venomix666/SuperCPM65/README.md

# SuperCPM65
SNES cartrige for CP/M-65, still an untested work in progress
