venomix666/SuperCPM65/SuperCPM65_BOM.ods

Reference | Qty | Value | Footprint | Description | Supplier | Supplier P/N
C1,C2,C3,C5,C6,C7,C9,C10,C11,C12 | 10 | 100n | Capacitor_SMD:C_0805_2012Metric_Pad1.18x1.45mm_HandSolder | Unpolarized capacitor | Mouser | 581-KAM21BR71H104JT
C4,C8 | 2 | 2u2 | Capacitor_SMD:C_0805_2012Metric_Pad1.18x1.45mm_HandSolder | Unpolarized capacitor | Mouser | 581-KAF21KR71E225KU
D1,D2,D3,D4,D8,D9 | 6 | BAT42W-V | Diode_SMD:D_SOD-123 | 30V 0.2A Small Signal Schottky diode, SOD-123 | Mouser | 821-BAT42WRHG
D5,D6,D7 | 3 | LED | LED_SMD:LED_0805_2012Metric | Light emitting diode | Mouser | 604-AP2012SGD3
J1 | 1 | Conn_01x02 | Connector_PinHeader_2.54mm:PinHeader_1x02_P2.54mm_Vertical | Generic connector, single row, 01x02, script generated (kicad-library-utils/schlib/autogen/connector/) | Mouser | 538-22-28-4027
J2 | 1 | Conn_01x06 | Connector_PinHeader_2.54mm:PinHeader_1x06_P2.54mm_Vertical | Generic connector, single row, 01x06, script generated (kicad-library-utils/schlib/autogen/connector/) | Mouser | 538-22-28-4061
J3 | 1 | Conn_01x09 | Connector_PinHeader_2.54mm:PinHeader_1x09_P2.54mm_Vertical | Generic connector, single row, 01x09, script generated (kicad-library-utils/schlib/autogen/connector/) | Mouser | 538-22-28-4091
J4 | 1 | GSD090012SEU | SD_card:AMPHENOL_GSD090012SEU |  | Mouser | 523-GSD090012SEU
J5 | 1 | Mini-DIN-6 | PS2:TE 5749266-1 | 6-pin Mini-DIN connector | Mouser | 571-5749266-1
R1,R2,R3,R7 | 4 | 10k | Resistor_SMD:R_0805_2012Metric_Pad1.20x1.40mm_HandSolder | Resistor | Mouser | 603-RT0805FRE1010KL
R4,R5,R6 | 3 | 1k | Resistor_SMD:R_0805_2012Metric_Pad1.20x1.40mm_HandSolder | Resistor | Mouser | 660-SG73S2ATTD1001F
R8 | 1 | 33k | Resistor_SMD:R_0805_2012Metric_Pad1.20x1.40mm_HandSolder | Resistor | Mouser | 755-KTR10EZPF3302
U1 | 1 | 74HC14 | Package_SO:SOIC-14_3.9x8.7mm_P1.27mm | Hex inverter schmitt trigger | Mouser | 757-74HC14D
U2 | 1 | PIC12F629-IP | Package_DIP:DIP-8_W7.62mm_Socket |  | Mouser | 579-PIC12F629IP
U3 | 1 | SST39SF010 | Package_DIP:DIP-32_W15.24mm_Socket | Silicon Storage Technology (SSF) 128k x 8 Flash ROM | Mouser | 804-39SF010A7CPHE
U4 | 1 | W65C22NxP | Package_DIP:DIP-40_W15.24mm | CMOS Versatile Interface Adapter (VIA), 20-pin I/O, 2 Timer/Counters, NMOS-Compatible, DIP-40 | Mouser | 955-W65C22S6TPG-14
U5,U6 | 2 | 74HC595 | Package_SO:SOIC-16_3.9x9.9mm_P1.27mm | 8-bit serial in/out Shift Register 3-State Outputs | Mouser | 771-74HCT595DQ100118
U7 | 1 | TXB0104D | Package_SO:SOIC-14_3.9x8.7mm_P1.27mm | 4-Bit Bidirectional Voltage-Level Translator, Auto Direction Sensing and ±15-kV ESD Protection, 1.2 - 3.6V APort, 1.65 - 5.5V BPort, SOIC-14 | Mouser | 595-TXB0104D
U8 | 1 | AP2205-33W5-7 | Package_TO_SOT_SMD:SOT-23-5 | 200mA low dropout linear regulator, wide input voltage range, 3.3V fixed positive output, SOT-23-5 | Mouser | 621-AP2205-33W5-7
