venomix666/SuperCPM65/Local_lib/PS2/c-5749266-1-a-3d.stp

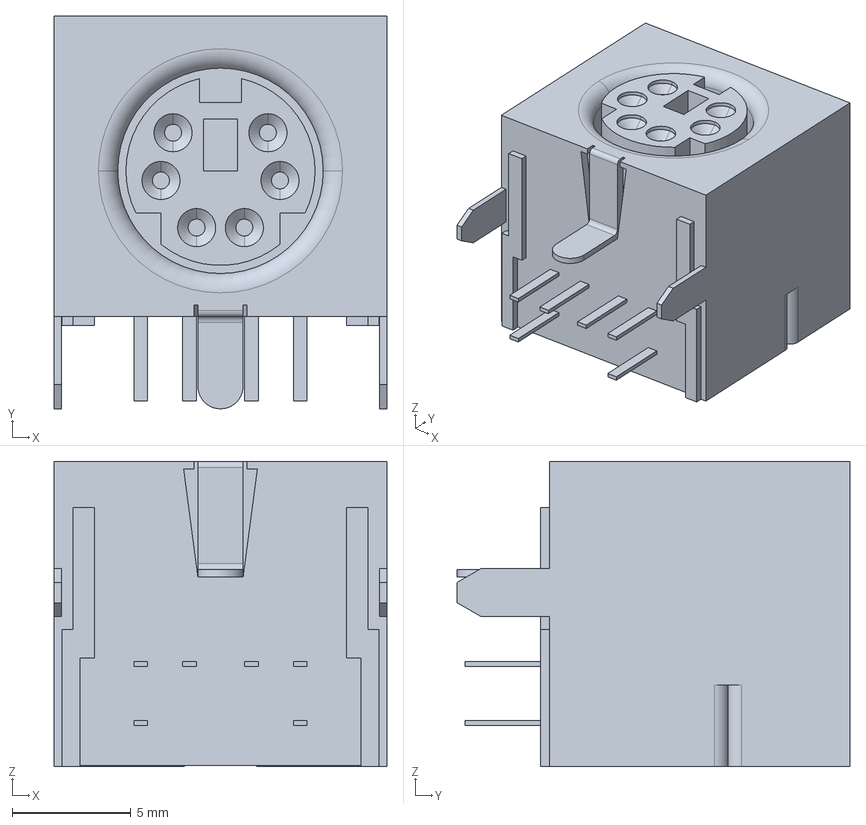
[picture p1: CAD file, 2025-03-16]
Local_lib/PS2/c-5749266-1-a-3d.stp
14.0 x 16.5 x 12.8 mm
