venomix666/SuperCPM65/Local_lib/step_files/DIP-32 W15.24mm IC with Socket.stp

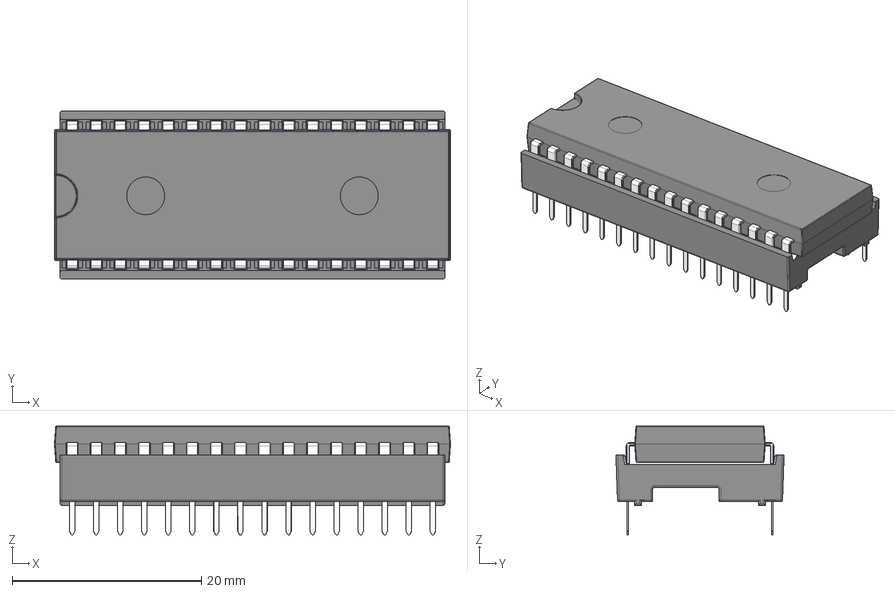
[picture p2: CAD file, 2025-03-16]
Local_lib/step_files/DIP-32 W15.24mm IC with Socket.stp
41.8 x 17.8 x 11.5 mm
Stamped Dual Wipe Contact for DIP Sockets x 32
Body DIP-48 Socket
IC Beinchen x 32
DIP-32 W15.24
