venomix666/SuperCPM65/Local_lib/step_files/DIP-8 W7.62mm IC with Socket.stp

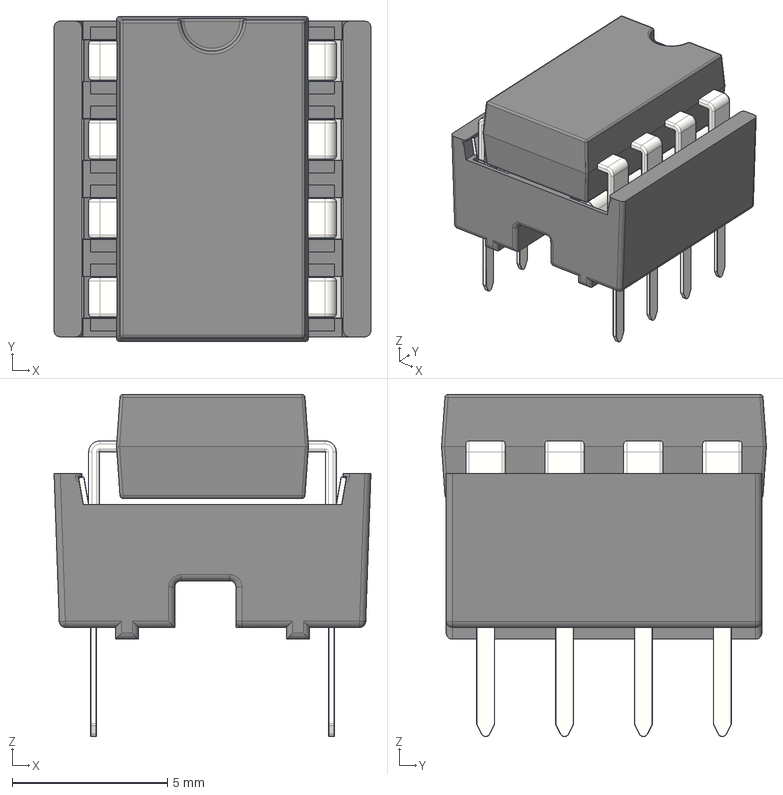
[picture p3: CAD file, 2025-03-16]
Local_lib/step_files/DIP-8 W7.62mm IC with Socket.stp
10.2 x 10.5 x 11.0 mm
Stamped Dual Wipe Contact for DIP Sockets x 8
Body DIP-8 P7.62mm Socket
IC Beinchen x 8
DIP-8 W7.62
