venomix666/SuperCPM65/Local_lib/SD_card/GSD090012SEU.step

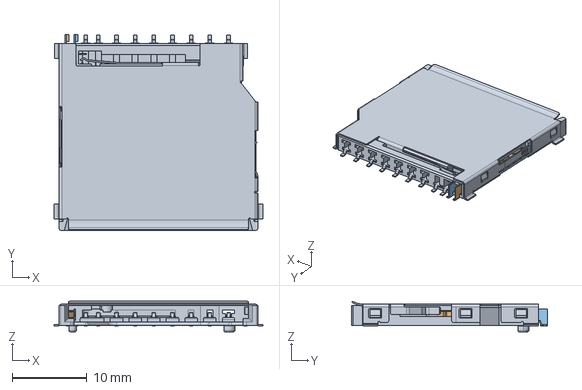
[picture p4: CAD file, 2025-03-16]
Local_lib/SD_card/GSD090012SEU.step
28.0 x 26.2 x 4.13 mm
