venomix666/SuperCPM65/Assembly_Drawing/SuperCPM65__Assembly.pdf

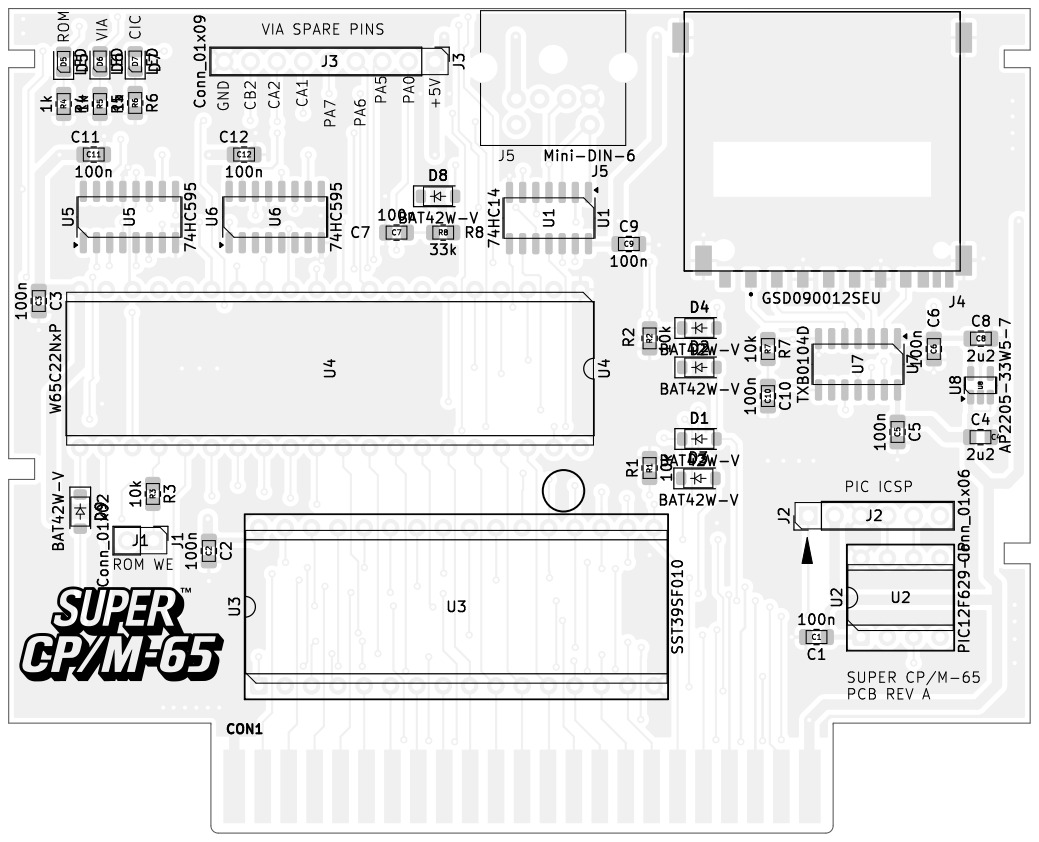
[picture p5: page 1]

CIC CA1 PA0 SUPER CP/M-65 PCB REV A PA6CA2 PA7PA5 +5V ROM WE CB2 PIC ICSP VIAVIA SPARE PINS GND ROM U5 D3 U4U7 J2 J3 C7 R5 C6 C4

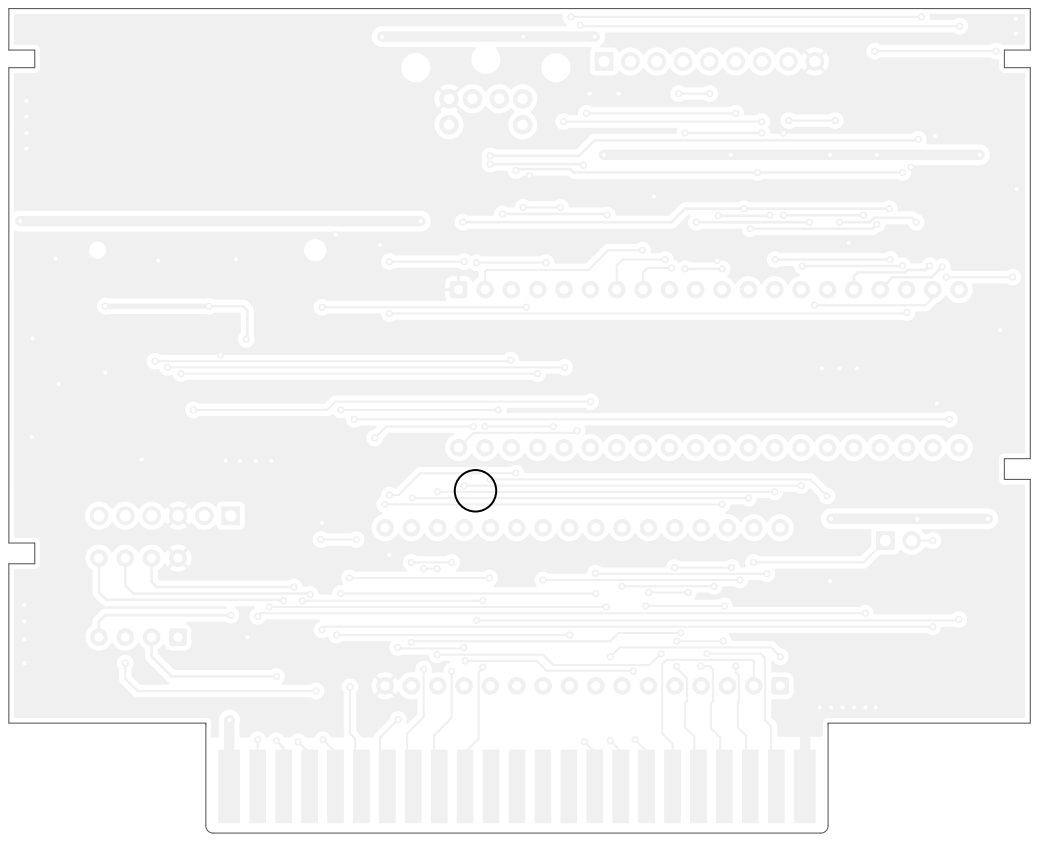
[picture p6: page 2]
D Date: KiCad; E.D.A. 9.0.1 Size: A4; Rev:; Id: /1 Title: File: SuperCPM65.kicad_pcb Sheet: Black; And; White; BOT Board2Pdf:; Black; BOT -; Page 2/2
