venomix666/SuperCPM65/Schematics/SuperCPM65_Schematics_PA5.pdf

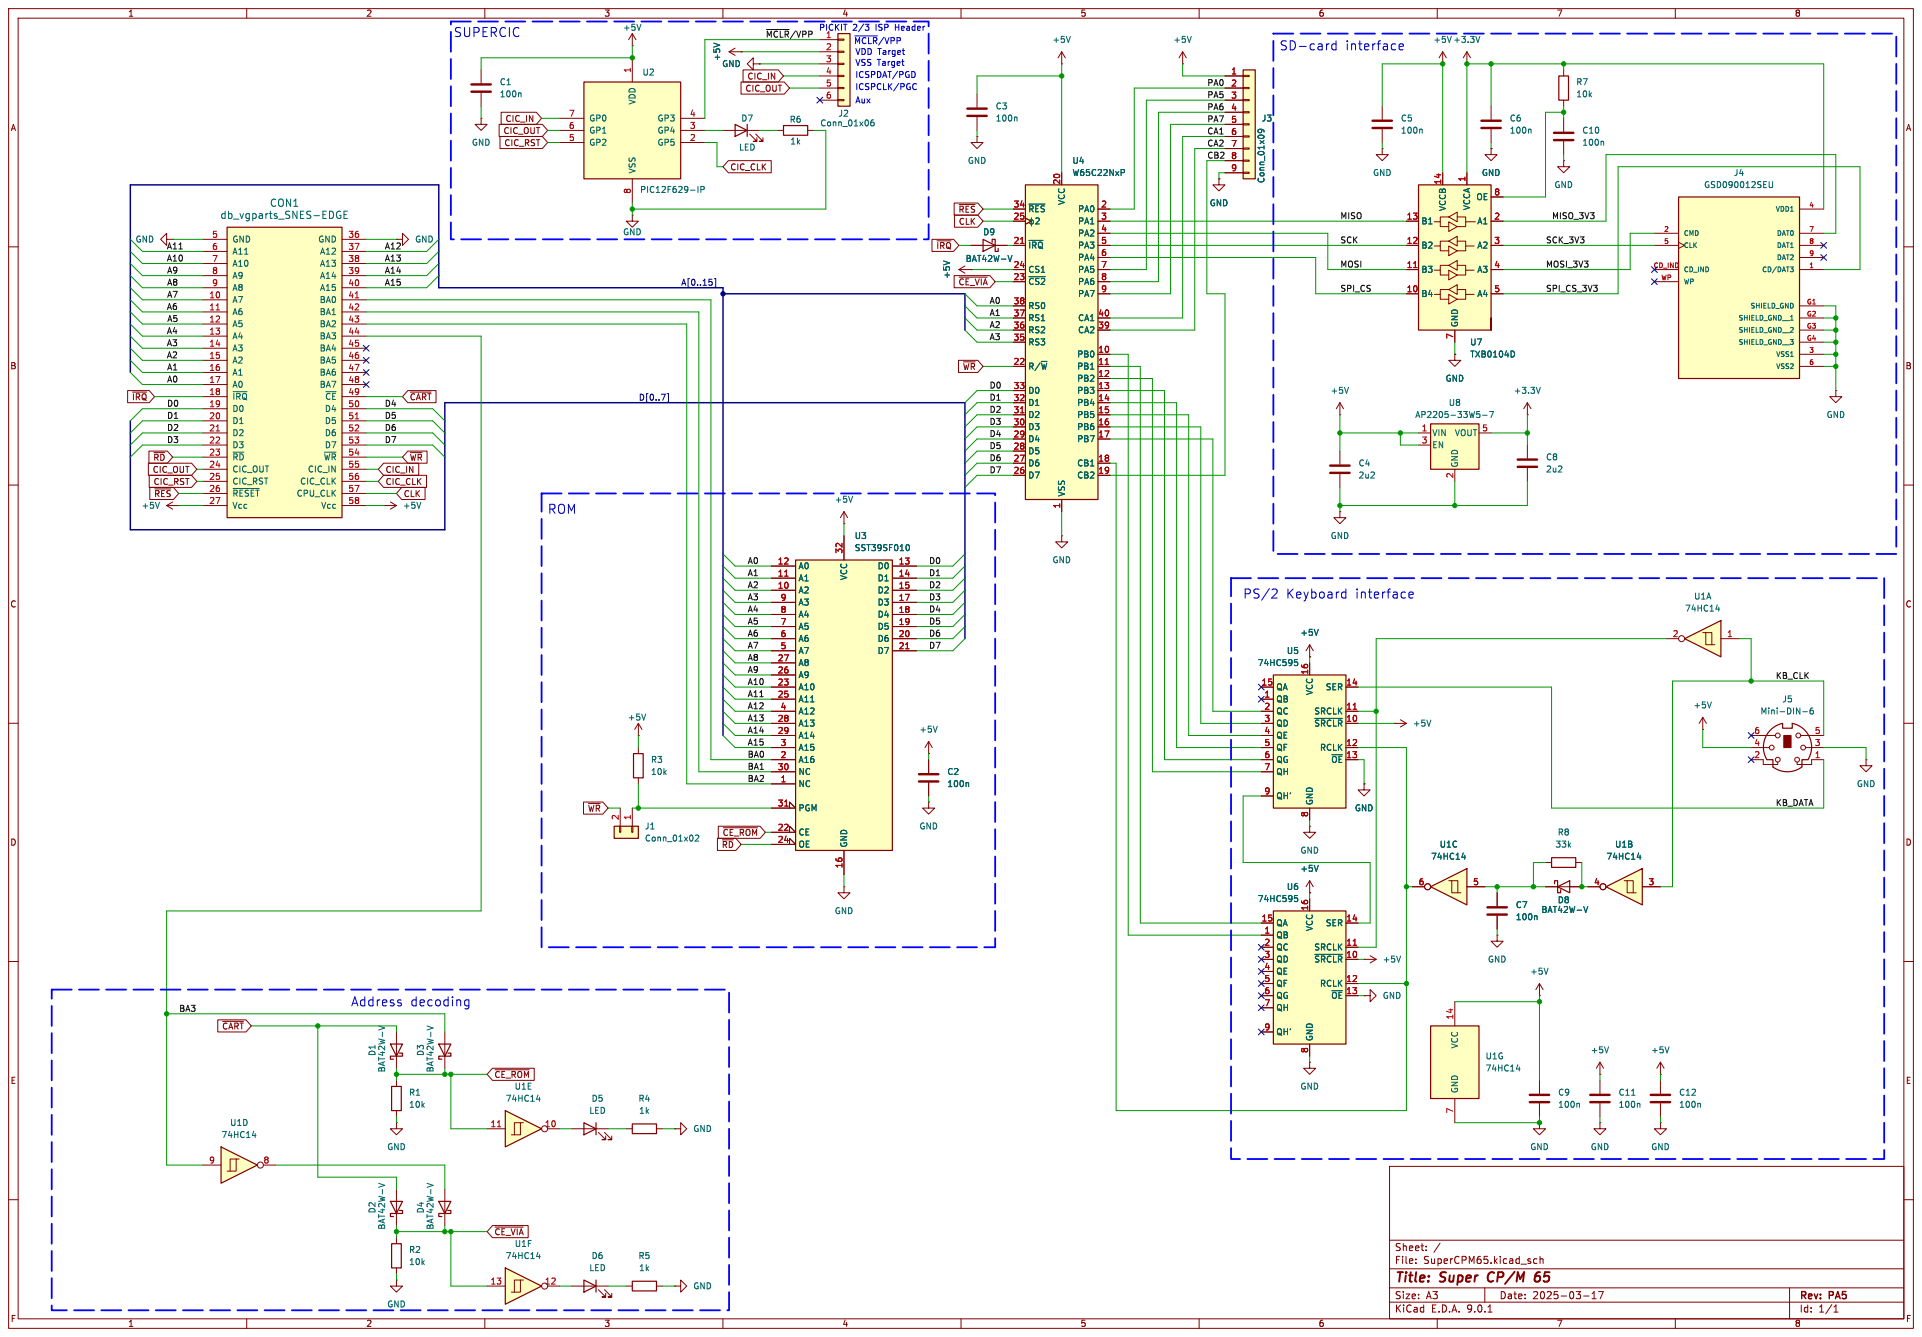
[picture p7: page 1]

VDD Target Aux SUPERCIC

SER 14 SRCLK 11 ~{SRCLR} 10 RCLK 12 ~{OE} 13 VCC 16 GND

GND

Id: 1/1 Title: Super CP/M 65
