venomix666/SuperCPM65/SuperCPM65.kicad_pcb

## KiCad design SuperCPM65.kicad_pcb (2025-04-09)

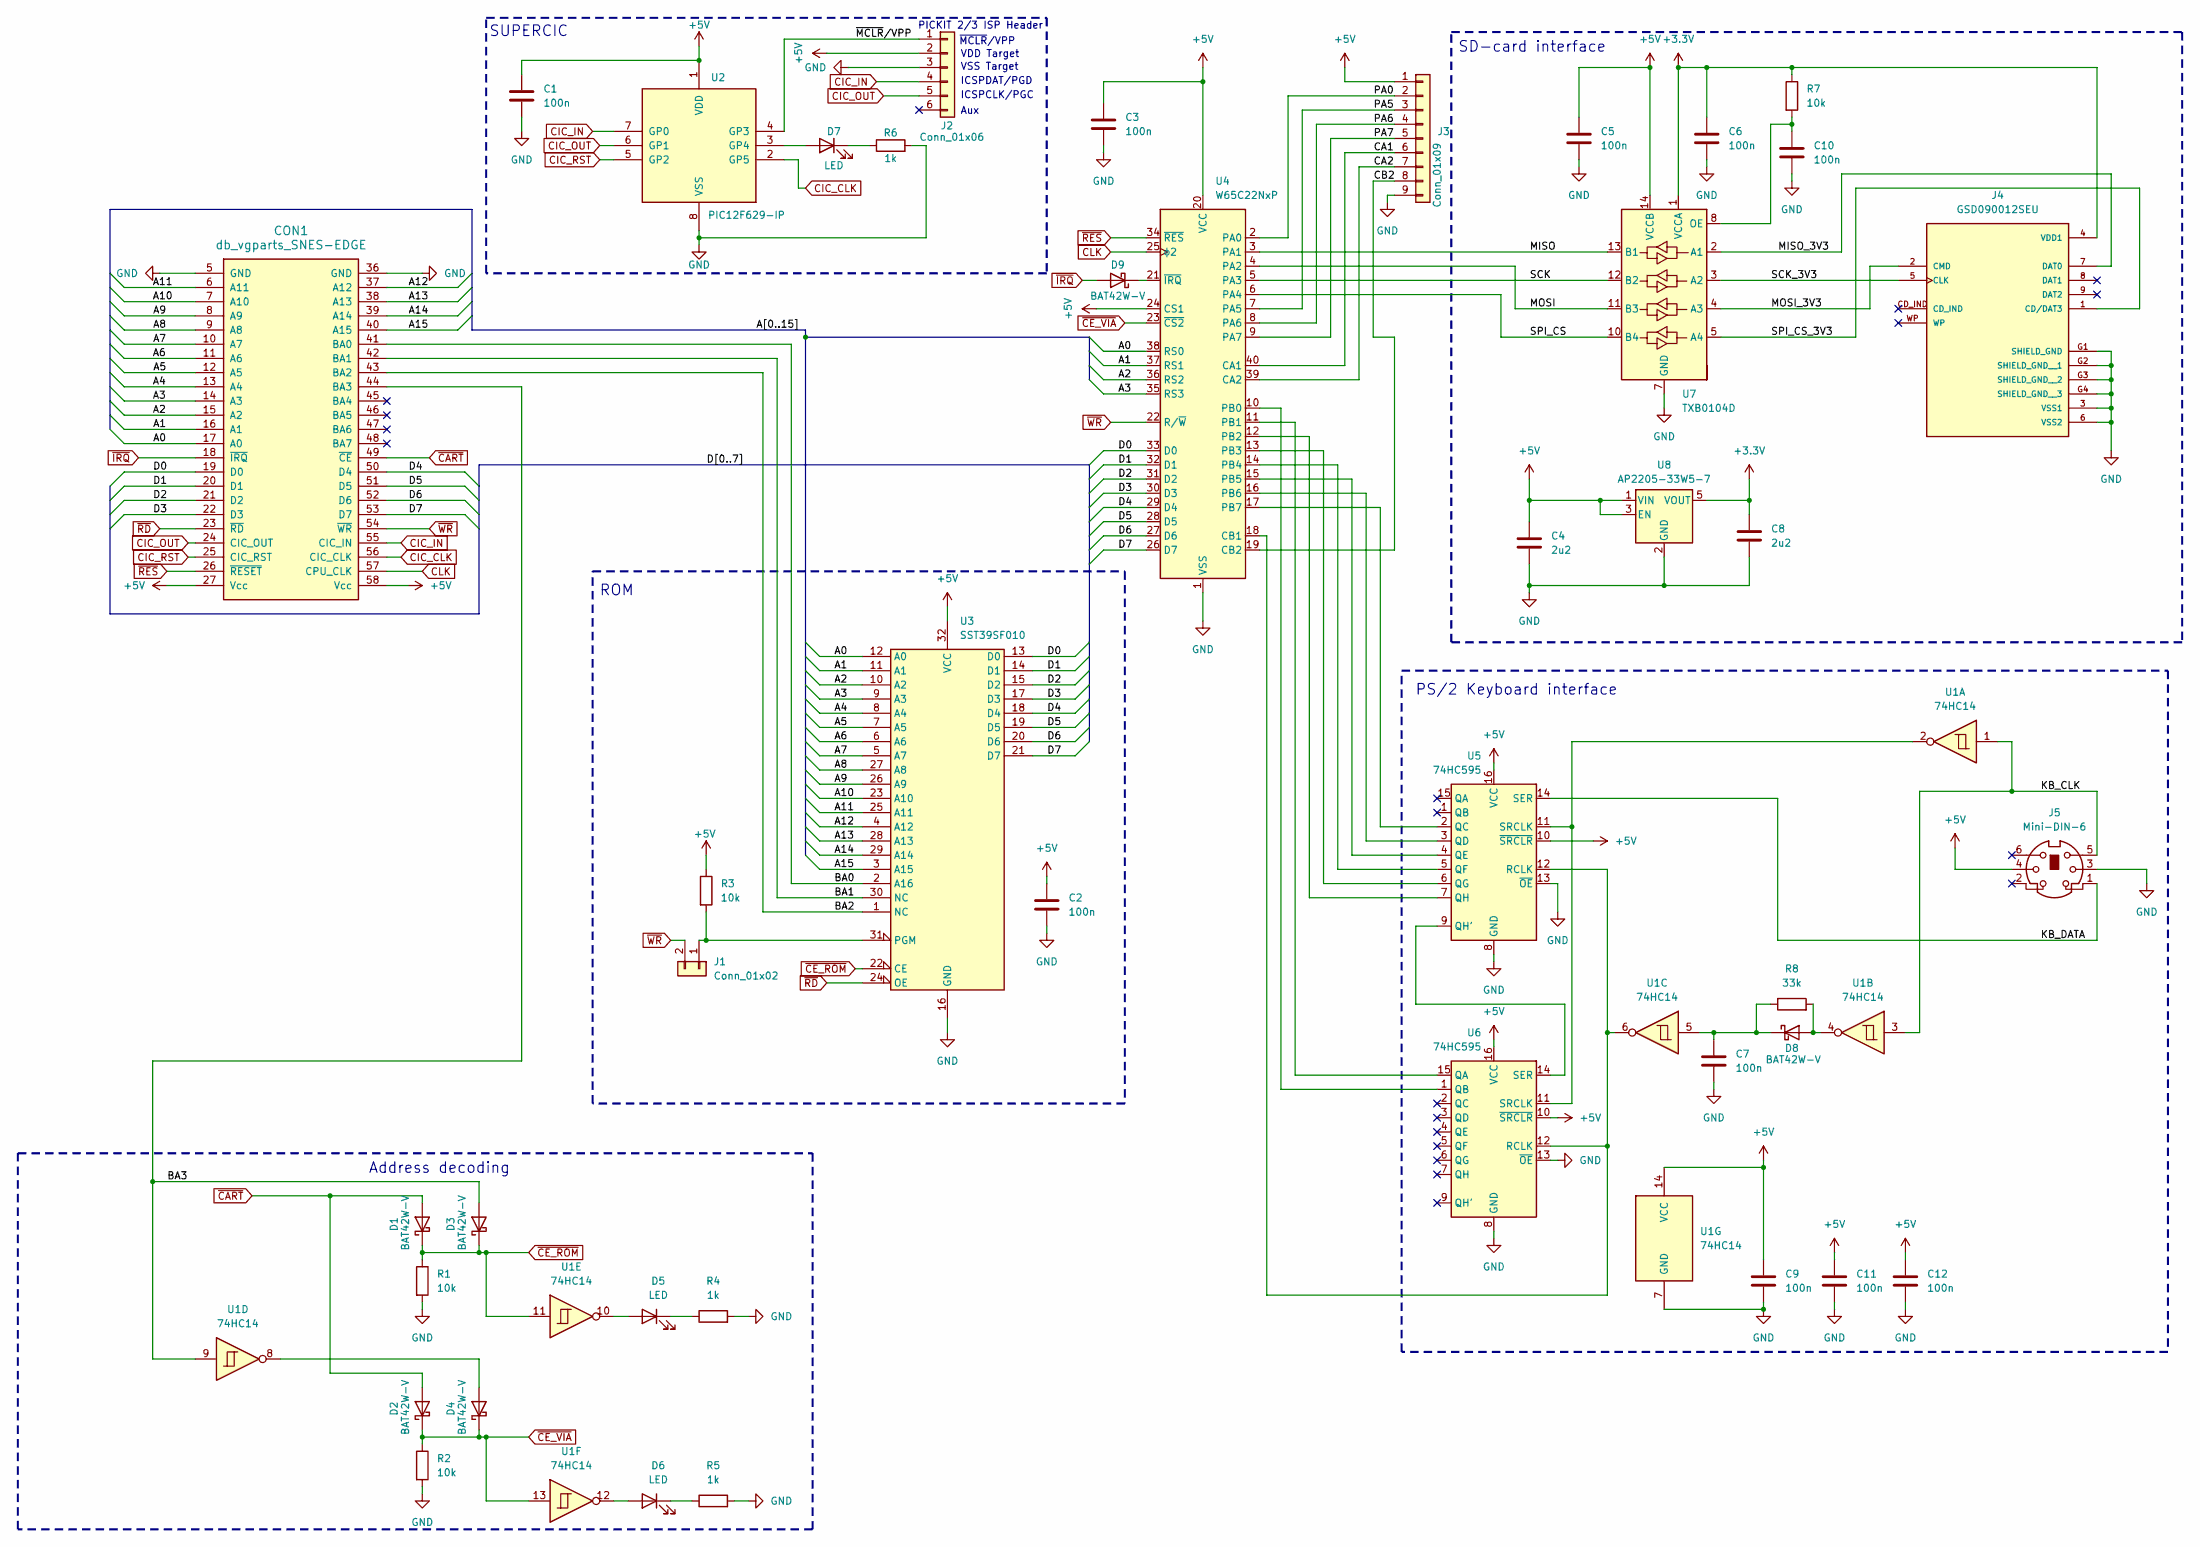
[picture p8: schematic SuperCPM65.kicad_sch, Super CP/M 65]

Parts:
C1, C2, C3, C5, C6, C7, C9, C10, C11, C12: 100n; C_0805_2012Metric_Pad1.18x1.45mm_HandSolder
C4, C8: 2u2; C_0805_2012Metric_Pad1.18x1.45mm_HandSolder
CON1: db_vgparts_SNES-EDGE; SNES-EDGE-Bigger
D1, D2, D3, D4, D8, D9: BAT42W-V; D_SOD-123
D5, D6, D7: LED; LED_0805_2012Metric
J1: Conn_01x02; PinHeader_1x02_P2.54mm_Vertical
J2: Conn_01x06; PinHeader_1x06_P2.54mm_Vertical
J3: Conn_01x09; PinHeader_1x09_P2.54mm_Vertical
J4: GSD090012SEU; AMPHENOL_GSD090012SEU; PARTREV E
J5: Mini-DIN-6; TE 5749266-1
R1, R2, R3, R7: 10k; R_0805_2012Metric_Pad1.20x1.40mm_HandSolder
R4, R5, R6: 1k; R_0805_2012Metric_Pad1.20x1.40mm_HandSolder
R8: 33k; R_0805_2012Metric_Pad1.20x1.40mm_HandSolder
U1: 74HC14; SOIC-14_3.9x8.7mm_P1.27mm
U2: PIC12F629-IP; DIP-8_W7.62mm_Socket
U3: SST39SF010; DIP-32_W15.24mm_Socket
U4: W65C22NxP; DIP-40_W15.24mm
U5, U6: 74HC595; SOIC-16_3.9x9.9mm_P1.27mm
U7: TXB0104D; SOIC-14_3.9x8.7mm_P1.27mm
U8: AP2205-33W5-7; SOT-23-5

Connections:
+3.3V: C6.1, C8.1, J4.4 (VDD1), R7.1, U7.1 (VCCA), U8.5 (VOUT)
+5V: C1.1, C2.1, C3.1, C4.1, C5.1, C9.1, C11.1, C12.1, CON1.27 (Vcc), CON1.58 (Vcc), J2.2, J3.1, J5.4, R3.1, U1.14 (VCC), U2.1 (VDD), U3.32 (VCC), U4.20 (VCC), U4.24 (CS1), U5.10 (~SRCLR), U5.16 (VCC), U6.10 (~SRCLR), U6.16 (VCC), U7.14 (VCCB), U8.1 (VIN), U8.3 (EN)
/A0: CON1.17 (A0), U3.12 (A0), U4.38 (RS0)
/A1: CON1.16 (A1), U3.11 (A1), U4.37 (RS1)
/A2: CON1.15 (A2), U3.10 (A2), U4.36 (RS2)
/A3: CON1.14 (A3), U3.9 (A3), U4.35 (RS3)
/A4: CON1.13 (A4), U3.8 (A4)
/A5: CON1.12 (A5), U3.7 (A5)
/A6: CON1.11 (A6), U3.6 (A6)
/A7: CON1.10 (A7), U3.5 (A7)
/A8: CON1.9 (A8), U3.27 (A8)
/A9: CON1.8 (A9), U3.26 (A9)
/A10: CON1.7 (A10), U3.23 (A10)
/A11: CON1.6 (A11), U3.25 (A11)
/A12: CON1.37 (A12), U3.4 (A12)
/A13: CON1.38 (A13), U3.28 (A13)
/A14: CON1.39 (A14), U3.29 (A14)
/A15: CON1.40 (A15), U3.3 (A15)
/BA0: CON1.41 (BA0), U3.2 (A16)
/BA1: CON1.42 (BA1), U3.30 (NC)
/BA2: CON1.43 (BA2), U3.1 (NC)
/BA3: CON1.44 (BA3), D3.2 (A), U1.9
/CA1: J3.6, U4.40 (CA1)
/CA2: J3.7, U4.39 (CA2)
/CB2: J3.8, U4.19 (CB2)
/D0: CON1.19 (D0), U3.13 (D0), U4.33 (D0)
/D1: CON1.20 (D1), U3.14 (D1), U4.32 (D1)
/D2: CON1.21 (D2), U3.15 (D2), U4.31 (D2)
/D3: CON1.22 (D3), U3.17 (D3), U4.30 (D3)
/D4: CON1.50 (D4), U3.18 (D4), U4.29 (D4)
/D5: CON1.51 (D5), U3.19 (D5), U4.28 (D5)
/D6: CON1.52 (D6), U3.20 (D6), U4.27 (D6)
/D7: CON1.53 (D7), U3.21 (D7), U4.26 (D7)
/KB_CLK: J5.5, U1.1, U1.3
/KB_DATA: J5.1, U5.14 (SER)
/MISO: U4.3 (PA1), U7.13 (B1)
/MISO_3V3: J4.7 (DAT0), U7.2 (A1)
/MOSI: U4.4 (PA2), U7.11 (B3)
/MOSI_3V3: J4.2 (CMD), U7.4 (A3)
/PA0: J3.2, U4.2 (PA0)
/PA5: J3.3, U4.7 (PA5)
/PA6: J3.4, U4.8 (PA6)
/PA7: J3.5, U4.9 (PA7)
/SCK: U4.5 (PA3), U7.12 (B2)
/SCK_3V3: J4.5 (CLK), U7.3 (A2)
/SPI_CS: U4.6 (PA4), U7.10 (B4)
/SPI_CS_3V3: J4.1 (CD/DAT3), U7.5 (A4)
/~MCLR/VPP: J2.1, U2.4 (GP3)
CIC_CLK: CON1.56 (CIC_CLK), U2.2 (GP5)
CIC_IN: CON1.55 (CIC_IN), J2.4, U2.7 (GP0)
CIC_OUT: CON1.24 (CIC_OUT), J2.5, U2.6 (GP1)
CIC_RST: CON1.25 (CIC_RST), U2.5 (GP2)
CLK: CON1.57 (CPU_CLK), U4.25 (ϕ2)
GND: C1.2, C2.2, C3.2, C4.2, C5.2, C6.2, C7.2, C8.2, C9.2, C10.2, C11.2, C12.2, CON1.5 (GND), CON1.36 (GND), J2.3, J3.9, J4.3 (VSS1), J4.6 (VSS2), J4.G1 (SHIELD_GND), J4.G2 (SHIELD_GND__1), J4.G3 (SHIELD_GND__2), J4.G4 (SHIELD_GND__3), J5.3, R1.2, R2.2, R4.2, R5.2, R6.2, U1.7 (GND), U2.8 (VSS), U3.16 (GND), U4.1 (VSS), U5.8 (GND), U5.13 (~OE), U6.8 (GND), U6.13 (~OE), U7.7 (GND), U8.2 (GND)
unnamed: D4.2 (A), U1.8
unnamed: D5.2 (A), U1.10
unnamed: D5.1 (K), R4.1
unnamed: D6.2 (A), U1.12
unnamed: D6.1 (K), R5.1
unnamed: D7.2 (A), U2.3 (GP4)
unnamed: D7.1 (K), R6.1
unnamed: D8.2 (A), R8.2, U1.4
unnamed: C7.1, D8.1 (K), R8.1, U1.5
unnamed: D9.1 (K), U4.21 (~IRQ)
unnamed: J1.1, R3.2, U3.31 (PGM)
unnamed: U1.6, U4.18 (CB1), U5.12 (RCLK), U6.12 (RCLK)
unnamed: U4.10 (PB0), U6.1 (QB)
unnamed: U4.11 (PB1), U6.15 (QA)
unnamed: U4.12 (PB2), U5.7 (QH)
unnamed: U4.13 (PB3), U5.6 (QG)
unnamed: U4.14 (PB4), U5.5 (QF)
unnamed: U4.15 (PB5), U5.4 (QE)
unnamed: U4.16 (PB6), U5.3 (QD)
unnamed: U4.17 (PB7), U5.2 (QC)
unnamed: U5.9 (QH'), U6.14 (SER)
unnamed: U1.2, U5.11 (SRCLK), U6.11 (SRCLK)
unnamed: C10.1, R7.2, U7.8 (OE)
~CART: CON1.49 (~CE), D1.2 (A), D2.2 (A)
~CE_ROM: D1.1 (K), D3.1 (K), R1.1, U1.11, U3.22 (CE)
~CE_VIA: D2.1 (K), D4.1 (K), R2.1, U1.13, U4.23 (~CS2)
~IRQ: CON1.18 (~IRQ), D9.2 (A)
~RD: CON1.23 (~RD), U3.24 (OE)
~RES: CON1.26 (~RESET), U4.34 (~RES)
~WR: CON1.54 (~WR), J1.2, U4.22 (R/~W)

Notes on the sheet:
SUPERCIC
Address decoding
SD-card interface
~{MCLR}/VPP
ROM
VDD Target
PS/2 Keyboard interface
VSS Target
ICSPCLK/PGC
Aux
PICKIT 2/3 ISP Header
ICSPDAT/PGD

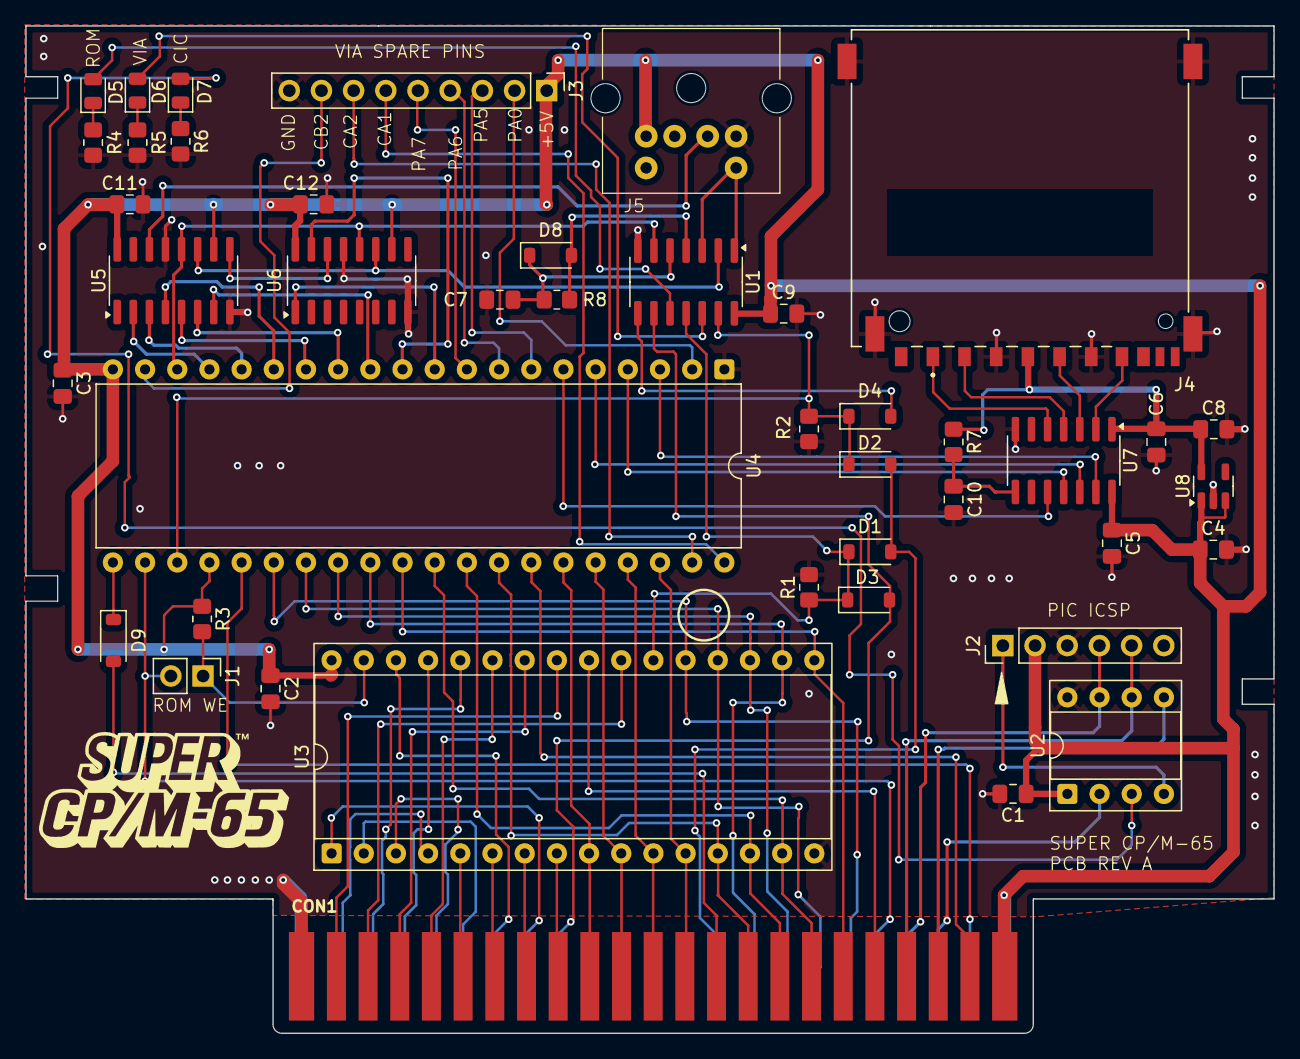
[picture p9: board SuperCPM65.kicad_pcb from above]

Board: 2 copper layers, 98.5 x 79.5 mm, 43 parts (0 on the bottom side), 84 nets.
