venomix666/SuperCPM65/(commit log)

2025-03-16 Initial add of project files
    [GSD090012SEU.step, SuperCPM65.kicad_pcb, SuperCPM65.kicad_sch, SuperCPM65_BOM.ods, c-5749266-1-a-3d.stp]
2025-03-16 Updated the 3D model for the socketed ROM
    [SuperCPM65.kicad_pcb]
2025-03-16 Routing updates
    [SuperCPM65.kicad_pcb]
2025-03-16 Fixed some 3D model issues and socketed the PIC
    [DIP-32 W15.24mm IC with Socket.stp, DIP-8 W7.62mm IC with Socket.stp, SuperCPM65.kicad_pcb, SuperCPM65.kicad_sch]
2025-03-17 Added LEDs for CE signals, header for leftover VIA I/Os, changed addressing to allow larger Flash memory and added a jumper for Flash memory write enable
    [SuperCPM65.kicad_sch]
2025-03-17 Reset component annotation as some components were removed
    [SuperCPM65.kicad_sch]
2025-03-17 Continued routing, more or less completed
    [SuperCPM65.kicad_pcb]
2025-03-17 Updated pdf schematics
2025-03-17 Updated BOM
    [SuperCPM65.kicad_sch, SuperCPM65_BOM.ods]
2025-03-18 Added stitching vias to improve ground plane impedance and fill ratio
    [SuperCPM65.kicad_pcb]
2025-03-18 Silkscreen cleanup etc.
    [SuperCPM65.kicad_pcb]
2025-03-18 Added gerber files for Rev A
    [SuperCPM65-B_Cu.gbr, SuperCPM65-B_Mask.gbr, SuperCPM65-B_Paste.gbr, SuperCPM65-B_Silkscreen.gbr, SuperCPM65-Edge_Cuts.gbr, SuperCPM65-F_Cu.gbr, SuperCPM65-F_Mask.gbr, SuperCPM65-F_Paste.gbr]
2025-03-18 Added assembly drawings and moved PDF schematics to its own directory
2025-03-20 Added more signals to VIA spare header. Added diode to IRQ line. Changed all diodes to schottky
    [SuperCPM65.kicad_sch]
2025-03-20 Imported schematic updated, placed LEDs at top, minor rearrangement
    [SuperCPM65.kicad_pcb]
2025-04-09 Updated gerbers and PDF schematics
    [SuperCPM65-B_Cu.gbr, SuperCPM65-B_Mask.gbr, SuperCPM65-B_Paste.gbr, SuperCPM65-B_Silkscreen.gbr, SuperCPM65-Edge_Cuts.gbr, SuperCPM65-F_Cu.gbr, SuperCPM65-F_Mask.gbr, SuperCPM65-F_Paste.gbr]
2025-04-10 Minor cleanup
    [SuperCPM65.kicad_sch]
